nekowokaburu/Single-Boiler-Espresso-Machine/Notes/FastHeatUp/FastHeatUp01.PNG

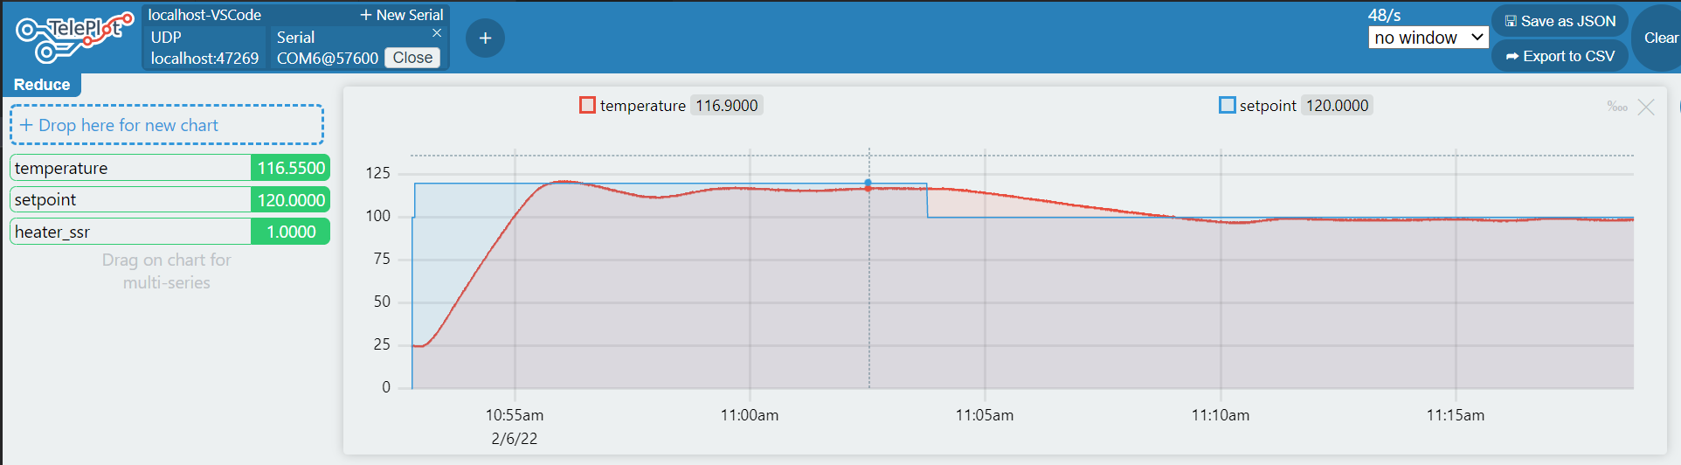
Notes/FastHeatUp/FastHeatUp01.PNG
