nekowokaburu/Single-Boiler-Espresso-Machine/Notes/SteamingMilk/SteamingMilk01.PNG

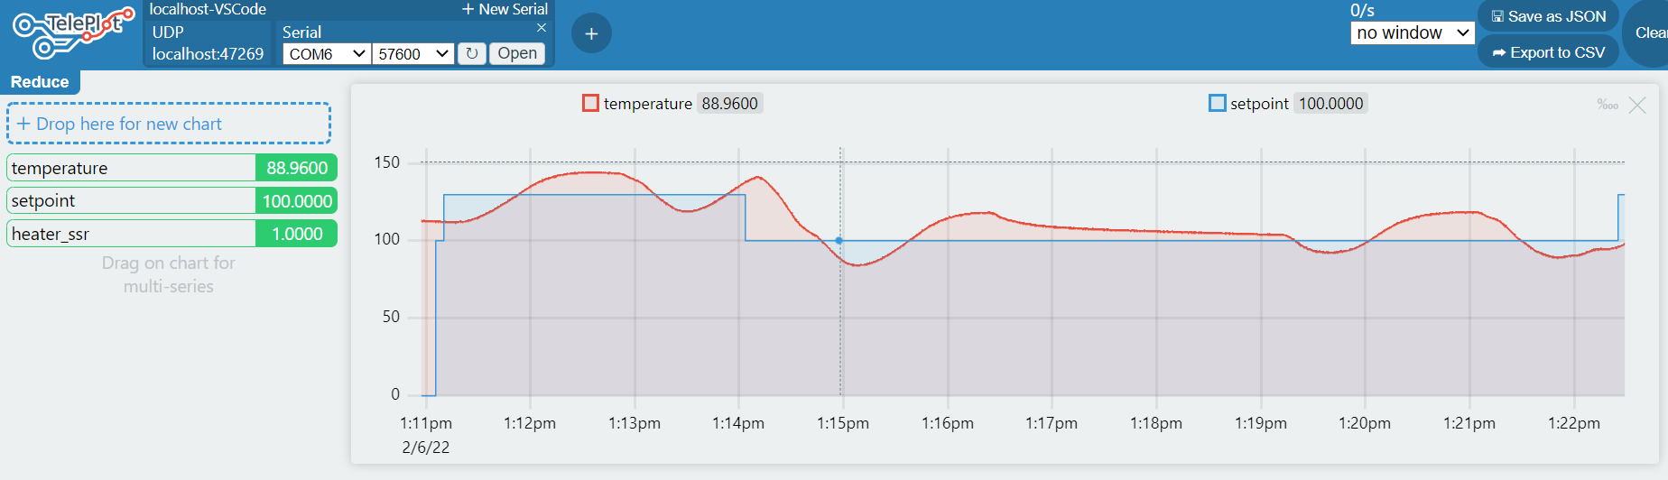
Notes/SteamingMilk/SteamingMilk01.PNG
