nekowokaburu/Single-Boiler-Espresso-Machine/Notes/TempDuringPreparationAndBrew/TempDuringPreparationAndBrew01.PNG

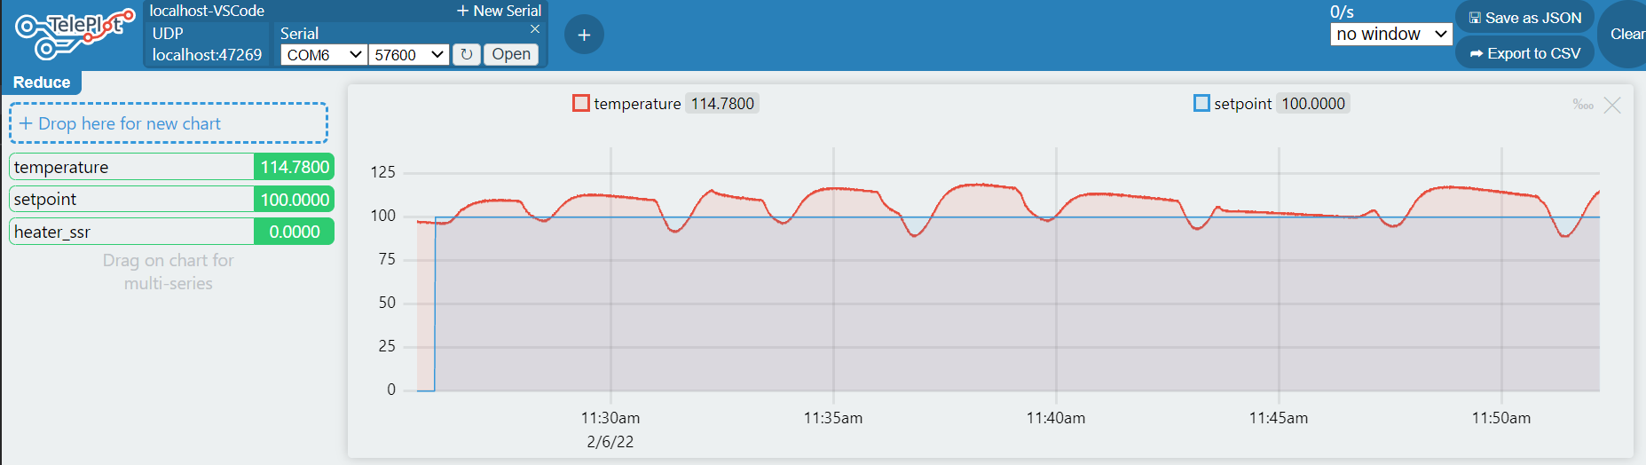
Notes/TempDuringPreparationAndBrew/TempDuringPreparationAndBrew01.PNG
