nekowokaburu/Single-Boiler-Espresso-Machine/PCB/BOM_PCB_General Espresso Machine Board (VBM)_2022-01-31.csv

ID | Name | Designator | Footprint | Quantity | Manufacturer Part | Manufacturer | Supplier | Supplier Part | Price | 3DModel | JLCPCB Part Class | description | link
1 | Screw Terminal | 3V3,5V,BOILER_SSR1_D3,BOILER_SSR2_D6,BTN_BREW,BTN_SWITCH_D7,BT_SWITCH_RESET,EXTERNAL_POWER_SWITCH_D5,LED0_D8,POWER_6-20V,PUMP_SSR_D9,REF,A2_A1,A6_A3,GND_A7 | TERMINAL_BLOCK_2P_5 | 15 | PA001-2P | HIWA | LCSC | C128027 | 0.125 |  |  | Screw Terminal
2 | 2685Y-106CNG1SNA01 | HC-05__STATE,I2C_01__GND,I2C_02__GND | HDR-TH_6P-P2.54-V | 3 | 2685Y-106CNG1SNA01 | 华宇创 | LCSC | C350307 | 0.074 | HDR2.54-M-LI-1X6P |  |  | https://item.szlcsc.com/38187.html
3 | TIP120 | TIP120 | TO-220 | 1 | TIP120 | STMicroelectronics | LCSC | C262990 | 0.767
4 | 1k | R1 | AXIAL-0.5 | 1 | MF1/2W-1KΩ±1% T52 | CCO | LCSC | C119418 | 0.021
5 | 2k | R2 | AXIAL-0.5 | 1 | MFR0S2F2001A20 | UniOhm | LCSC | C58578 | 0.012
6 | 2K | R4_D5_TIP120 | RES-TH_BD2.3-L6.5-P10.50-D0.5 | 1 | - | Chian Chia Elec | LCSC | C119330 | 0.008 | RES-TH_D2.3-L6.5-P10.50 |  |  | https://item.szlcsc.com/123457.html
7 | Header-Female-2.54_1x8 | SPI_CS_A0__VIN,SPI_CS_D4__VIN,SPI_CS_D10__VIN | HDR-TH_8P-P2.54-V-F-1 | 3 | Female headerHDR1X8-2.54 | BOOMELE | LCSC | C27438 | 0.091 | HDR-F-2.54_1x8 | Extended Part |  | https://item.szlcsc.com/290266.html
8 | Arduino_Nano_Header | ARDUINO_NANO_FEMALE_HEADER | DIP-30_L43.18-W15.24-ARDUINONANO | 1
