nekowokaburu/Single-Boiler-Espresso-Machine/(commit log)

2022-01-29 switch to using non-interrupt button, add brew button for lever, fix minor bugs
    [button.cpp, button.hpp, buttonBrew.hpp, heater.hpp, settings.hpp, vbm.cpp]
2022-02-01 Add pcb prototype
    [BOM_PCB_General Espresso Machine Board (VBM)_2022-01-31.csv, PickAndPlace_PCB_General Espresso Machine Board (VBM)_2022-01-31.csv]
2022-02-06 Add fast heat up notes and log
    [FastHeatUp01.csv]
2022-02-06 Add logs during flush and brew
    [TempDuringPrepartationAndBrew01.csv]
2022-02-06 Add steaming notes
    [SteamingMilk01.csv]
2022-02-22 Add rudimentary timer functionality and start eeprom saving
2022-02-23 ignore r n and fix timer bug
    [clock.hpp, communicator.cpp, communicator.hpp, settings.hpp, vbm.cpp]
2022-03-06 working timer with app time sync
2022-03-22 Use own PID library, use new PID settings, add doc with PID steaming example
2022-04-29 timer change
2022-04-29 reset timer state on new turn on time
    [clock.cpp]
2022-04-29 more timer variables reset once on change
    [clock.cpp, settings.hpp]
2022-05-06 switch DS3231 library for RTClib
2022-05-21 print temp
